stefan3n/shareable/JetsonControl/Documentation/Home.md

# **Smart Car 2025 - Documentation**

**1. [Introduction](Introduction/Introduction.md)** -  **project overview** and objectives.

**2. [Technical details](Technical/Technical.md)** - **explanations covering everything**, from the drivers used to the AI models and chosen frameworks.

**3. [Code breakdown](CodeFlow/packages.md)** - **brief descriptions** of the files that make up the developed software.

**4. [Conclusion](Conclusion/conclusion.md)** - **presentation of the final state** and the aspects that could be improved.
