stefan3n/shareable/JetsonControl/Documentation/Technical/IMU.md

### [< back](Technical.md)

# **IMU**

We used the **MPU6050 sensor** which includes a 3-axis accelerometer and gyroscope. This data can be integrated to provide a pose estimate, but alone it might be innacurate. It can be used alongside other sensors to get a better estimate of the pose.

## **Pinout**

The Jetson has some pins that are used as SDA and SCL pins for I2C Buses.

### **$$\color{red}!$$ $$\color{red}Bus$$ $$\color{red}number$$ $$\color{red}matters$$ $$\color{red}!$$**

### **Jetson Nano:**
* pin 3 -> SDA and 5 -> SCL are I2C Bus 1
* pin 27 -> SDA and 28 -> SCL are I2C Bus 0

### **Jetson Nano Orin:**
* pin 3 -> SDA and 5 -> SCL are I2C Bus 7
* pin 27 -> SDA and 28 -> SCL are I2C Bus 1

## **Setting up**

The sensor was connected to the Jetson's I2C bus (pins 3 and 5 or pins 27 and 28). To check if sensor is connected run this command:

 `sudo i2cdetect -r -y 1` - replace the *1* with the bus number you want to check.

In the grid displayed you should be able to to see your device's I2C addres. For our sensor it's 0x68 (the address *UU* means it's a kernel device, not any device that you connected).
