stefan3n/shareable/JetsonControl/Documentation/CodeFlow/JetsonControl/JetsonControl.md

### [< back](../packages.md)

# **JetsonControl**

This package includes all the files executed on the Jetson Orin Nano, organized into **dedicated sub-packages**.

***

* **[RosNodes](RosNodes.md)** 

 Includes all **ROS 2 nodes developed by us**, as well as **auxiliary files** implementing the functions used by these nodes.

* **[Server](Server.md)**

Includes all files necessary for the vehicle’s **control interface**.
