stefan3n/shareable/JetsonControl/RosNodes/arduino_wheels_writer_node.py

import rclpy
from rclpy.node import Node
from std_msgs.msg import String
import serial
import logging
import pyudev

# Set up logger for Arduino commands
arduino_logger = logging.getLogger("arduino_commands")
arduino_logger.setLevel(logging.INFO)
file_handler = logging.FileHandler("arduino_commands.log")
formatter = logging.Formatter('%(asctime)s - %(message)s')
file_handler.setFormatter(formatter)
arduino_logger.addHandler(file_handler)

class ArduinoWheelsWriterNode(Node):
    def __init__(self):
        super().__init__('arduino_wheels_writer_node')

        # Use pyudev to find the device with specific idVendor and idProduct
        context = pyudev.Context()
        device = None
        for dev in context.list_devices(subsystem='tty'):
            if dev.get('ID_VENDOR_ID') == '2a03' and dev.get('ID_MODEL_ID') == '0043':
                device = dev.device_node
                break

        if not device:
            raise RuntimeError('Arduino device not found with idVendor=2a03 and idProduct=0043')

        self.ser = serial.Serial(device, 115200, timeout=1)  # Connect to the identified device
        self.get_logger().info(f'Serial writer connected to Arduino on {device}.')

        self.subscription = self.create_subscription(
            String,
            'wheels_command_topic',
            self.command_callback,
            10
        )

    def command_callback(self, msg):
        # Log the command before sending
        arduino_logger.info(f"SENT TO ARDUINO: {msg.data.strip()}")
        self.ser.write(msg.data.encode())
        self.get_logger().info(f'Sent to Arduino: {msg.data.strip()}')

def main(args=None):
    rclpy.init(args=args)
    node = ArduinoWheelsWriterNode()
    rclpy.spin(node)
    node.destroy_node()

if __name__ == '__main__':
    main()
