stefan3n/shareable/(commit log)

2025-08-11 Camera wo web
2025-08-11 Camera wo web2
2025-08-11 Camera wo web3
2025-08-11 Camera wo web4
2025-08-11 Camera wo web5
